FordPrfkt/NixieClock/Boards/IN14_Display/IN14_Display.png

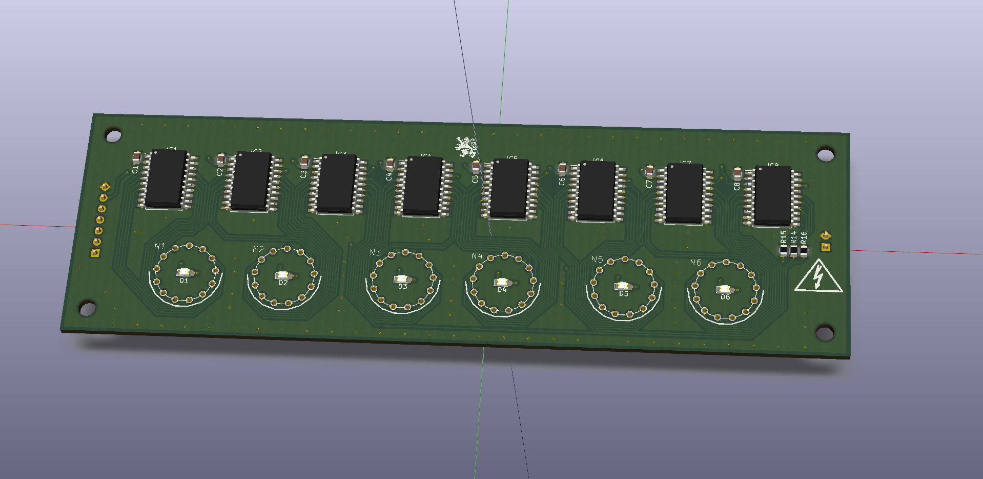
Boards/IN14_Display/IN14_Display.png
