FordPrfkt/NixieClock/Boards/Baseboard/Baseboard.png

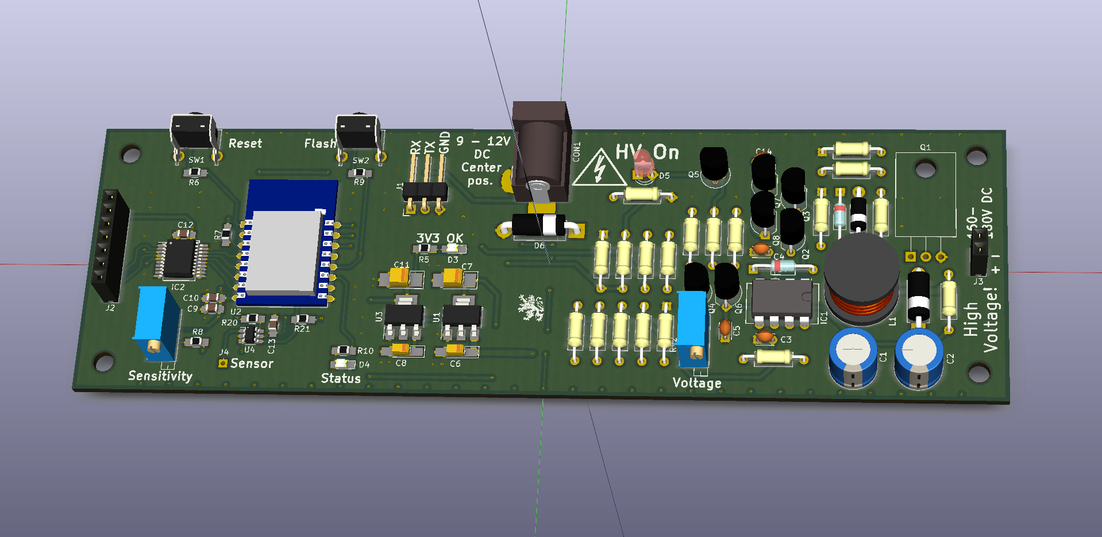
Boards/Baseboard/Baseboard.png
