FordPrfkt/NixieClock/README.md

# NixieClock
ESP12 based universal base board for nixie clocks and IN14-Tube board
