FordPrfkt/NixieClock/Boards/Baseboard/Baseboard.FCStd

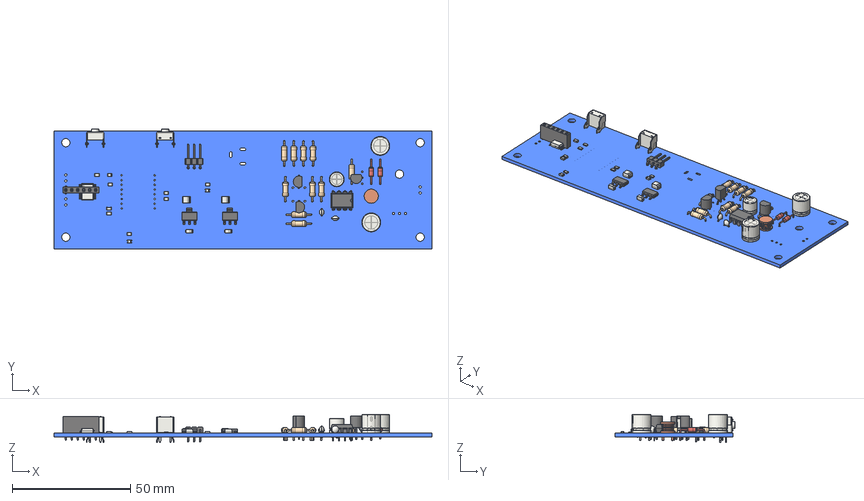
[picture p3: CAD file, 2018-03-19]
Boards/Baseboard/Baseboard.FCStd
160.0 x 50.8 x 12.0 mm
Pcb
DIP-8_W7.62mm_
TO-92_Inline_Wide_
C_0805_
C_0805_001
CP_Radial_D80mm_P350mm_
CP_Radial_D80mm_P350mm_001
C_Disc_D30mm_W20mm_P250mm_
CP_Radial_D63mm_P250mm_
C_Disc_D30mm_W20mm_P250mm_001
D_DO-35_SOD27_P10.16mm_Horizontal_
D_DO-35_SOD27_P10.16mm_Horizontal_001
D_0805_
D_0805_001
L_Radial_D6.0mm_P4.00mm_
R_Axial_DIN0207_L63mm_D25mm_P1016mm_Horizontal_
R_Axial_DIN0207_L63mm_D25mm_P1016mm_Horizontal_001
R_Axial_DIN0207_L63mm_D25mm_P1016mm_Horizontal_002
R_Axial_DIN0207_L63mm_D25mm_P1016mm_Horizontal_003
R_0805_
R_0805_001
R_0805_002
R_0805_003
R_0805_004
R_0805_005
SOT_223_
SOT_223_001
SW_Tactile_SPST_Angled_PTS645Vx39-2LFS_
SW_Tactile_SPST_Angled_PTS645Vx39-2LFS_001
CP_Tantalum_Case-A_EIA-3216-18_
CP_Tantalum_Case-B_EIA-3528-21_
CP_Tantalum_Case-A_EIA-3216-18_001
CP_Tantalum_Case-B_EIA-3528-21_001
R_Axial_DIN0207_L63mm_D25mm_P1016mm_Horizontal_004
R_Axial_DIN0207_L63mm_D25mm_P1016mm_Horizontal_005
R_Axial_DIN0207_L63mm_D25mm_P1016mm_Horizontal_006
Pin_Header_Angled_1x03_Pitch254mm_
PinSocket_1x06_P254mm_Vertical_
C_0805_002
SSOP-20_5.3x7.2mm_Pitch0.65mm_
TO-92_Inline_Wide_001
TO-92_Inline_Wide_002
R_Axial_DIN0207_L63mm_D25mm_P1016mm_Horizontal_007
R_Axial_DIN0207_L63mm_D25mm_P1016mm_Horizontal_008
R_Axial_DIN0207_L63mm_D25mm_P1016mm_Horizontal_009
