FordPrfkt/NixieClock/Boards/IN14_Display/IN14_Display.FCStd

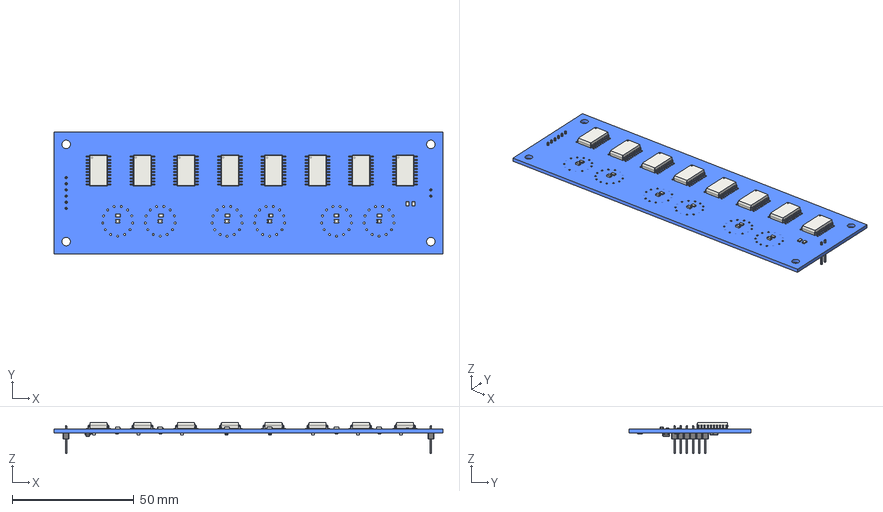
[picture p4: CAD file, 2018-03-19]
Boards/IN14_Display/IN14_Display.FCStd
160.0 x 50.0 x 12.9 mm
Pcb
C_0805_
C_0805_001
C_0805_002
C_0805_003
C_0805_004
C_0805_005
C_0805_006
D_0805_
D_0805_001
D_0805_002
D_0805_003
D_0805_004
D_0805_005
SOT_23_
SOIC-20W_7.5x12.8mm_Pitch1.27mm_
SOIC-20W_7.5x12.8mm_Pitch1.27mm_001
SOIC-20W_7.5x12.8mm_Pitch1.27mm_002
SOIC-20W_7.5x12.8mm_Pitch1.27mm_003
SOIC-20W_7.5x12.8mm_Pitch1.27mm_004
SOIC-20W_7.5x12.8mm_Pitch1.27mm_005
SOIC-20W_7.5x12.8mm_Pitch1.27mm_006
SOIC-20W_7.5x12.8mm_Pitch1.27mm_007
R_0805_
R_0805_001
R_0805_002
R_0805_003
R_0805_004
R_0805_005
R_0805_006
R_0805_007
R_0805_008
R_0805_009
R_0805_010
R_0805_011
R_0805_012
C_0805_007
Pin_Header_Straight_1x02_Pitch254mm_
Pin_Header_Straight_1x06_Pitch254mm_
R_0805_013
R_0805_014
