FordPrfkt/NixieClock/Boards/Baseboard/Baseboard.pdf

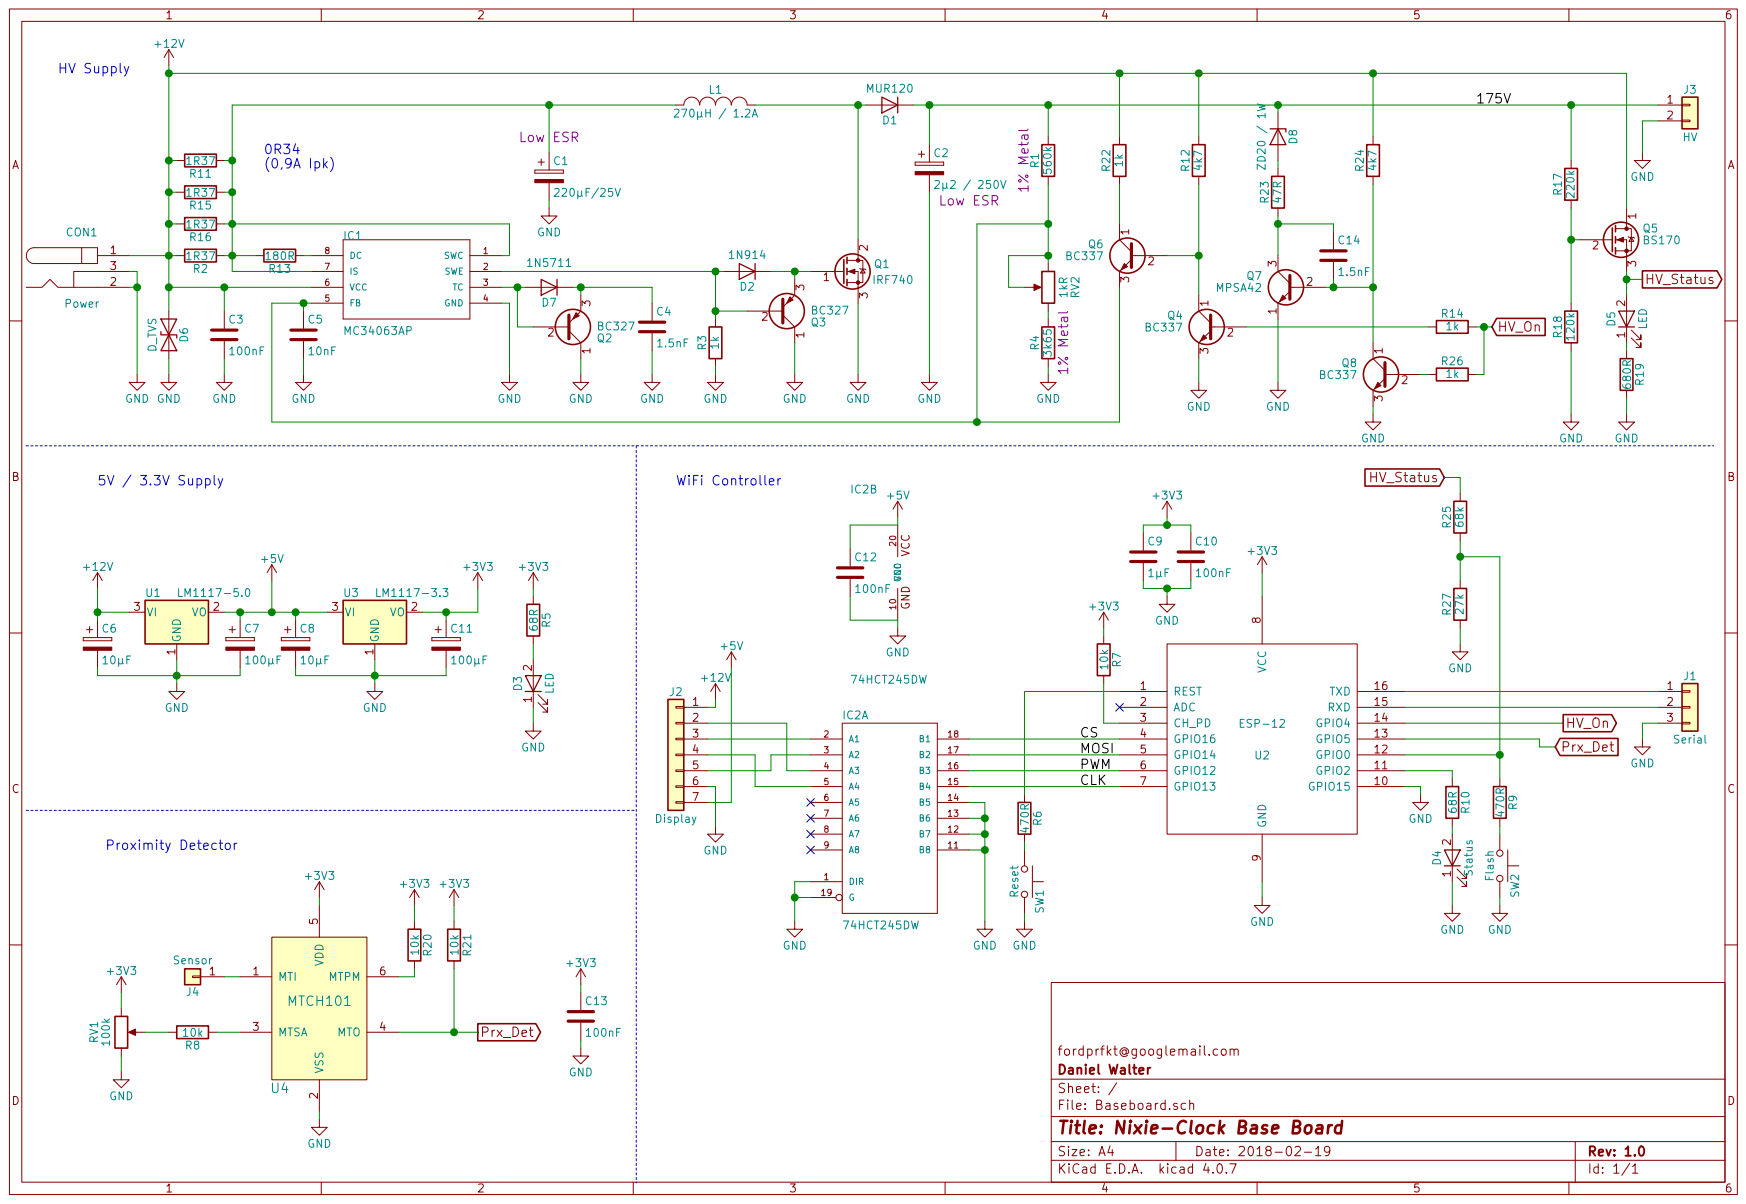
[picture p5: page 1]
