FordPrfkt/NixieClock/Boards/IN14_Display/IN14_Display.pdf

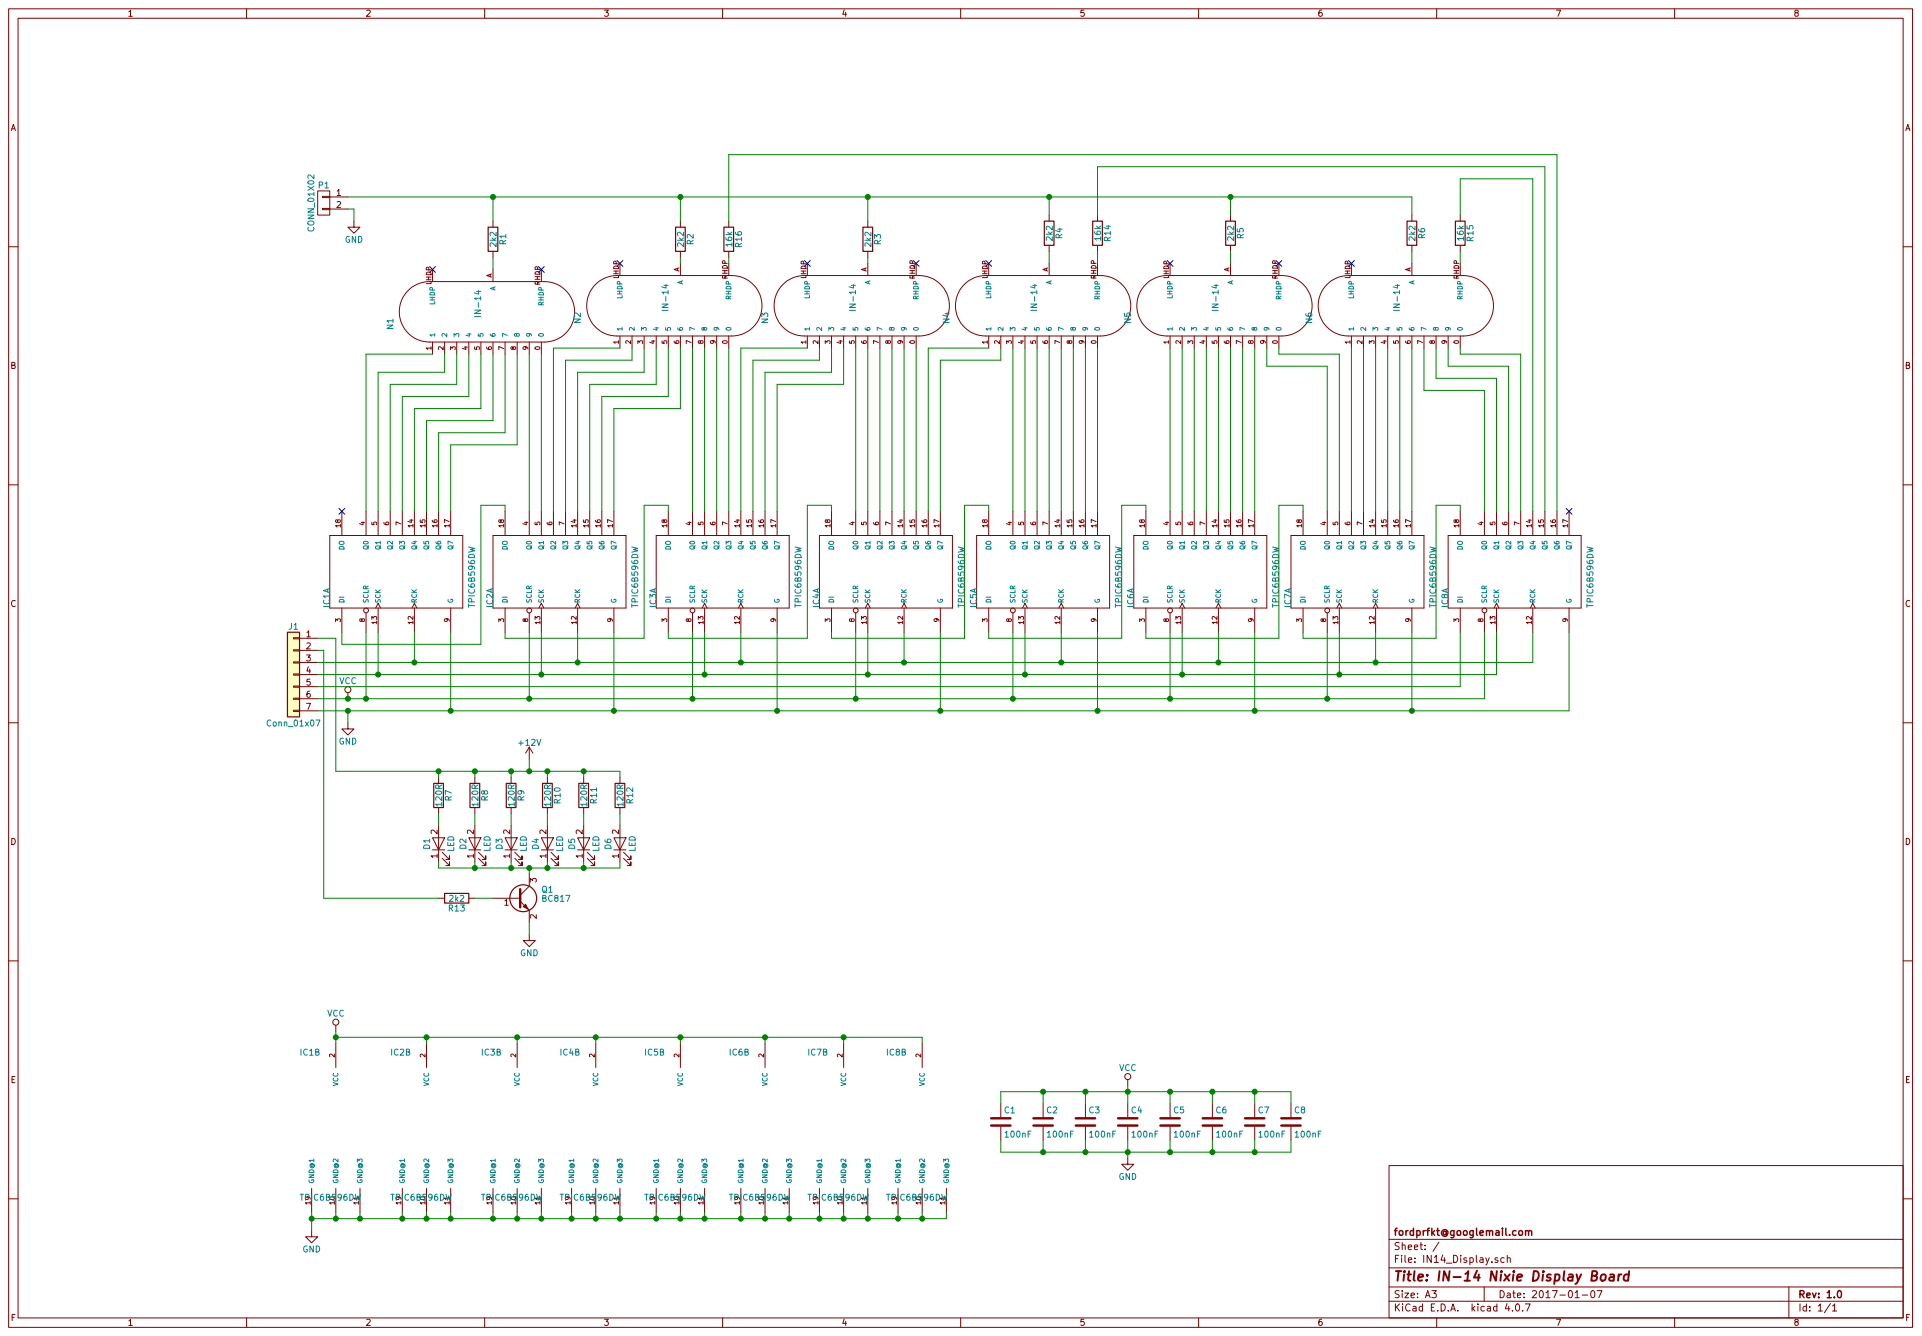
[picture p6: page 1]
