FordPrfkt/NixieClock/(list of files, drawings)

Other design files:
Boards/IN14_Display/IN14_Display.dsn
