FordPrfkt/NixieClock/Boards/Baseboard/Baseboard.kicad_pcb

## KiCad design Boards/Baseboard/Baseboard.kicad_pcb (2018-12-07)

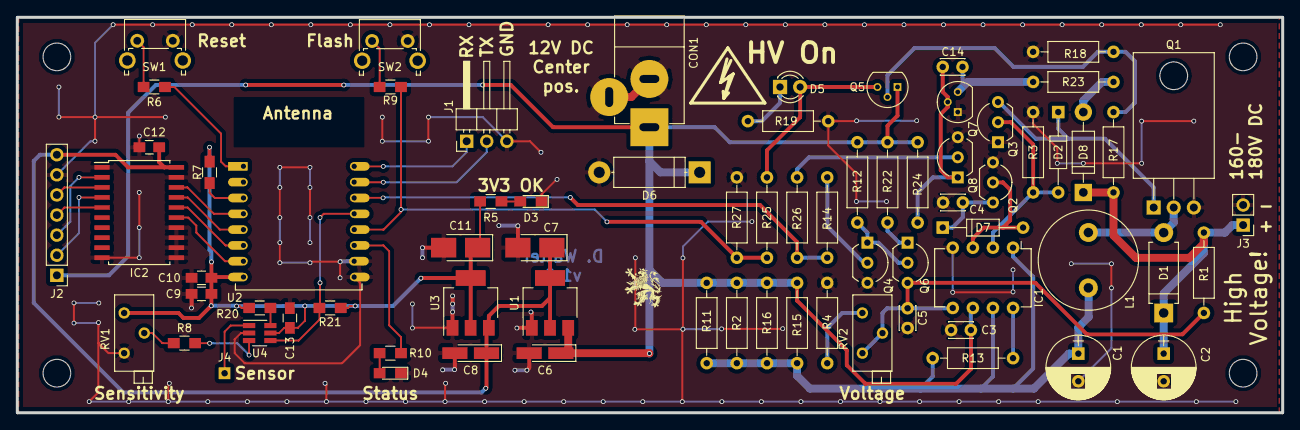
[picture p7: board Baseboard.kicad_pcb from above]

Board: 2 copper layers, 160.0 x 50.0 mm, 73 parts (0 on the bottom side), 48 nets.

Parts:
C1: 220µF/25V; CP_Radial_D8.0mm_P3.50mm
C2: 2µ2 / 250V; CP_Radial_D8.0mm_P3.50mm
C3: 100nF; C_Disc_D3.0mm_W2.0mm_P2.50mm
C4, C14: 1.5nF; C_Disc_D3.0mm_W2.0mm_P2.50mm
C5: 10nF; C_Disc_D3.0mm_W2.0mm_P2.50mm
C6, C8: 10µF; CP_Tantalum_Case-A_EIA-3216-18_Hand
C7, C11: 100µF; CP_Tantalum_Case-B_EIA-3528-21_Hand
C9: 1µF; C_0805_HandSoldering
C10, C12, C13: 100nF; C_0805_HandSoldering
CON1: Power; JACK_ALIM
D1: MUR120; D_DO-15_P10.16mm_Horizontal
D2: 1N914; D_DO-35_SOD27_P10.16mm_Horizontal
D3: LED; LED_0805_HandSoldering
D4: Status; LED_0805_HandSoldering
D5: LED; LED_D3.0mm
D6: D_TVS; D_5W_P12.70mm_Horizontal
D7: 1N5711; D_DO-35_SOD27_P10.16mm_Horizontal
D8: ZD20 / 1W; D_DO-41_SOD81_P10.16mm_Horizontal
IC1: MC34063AP; DIP-8_W7.62mm
IC2: 74HCT245DW; SOIC-20W_7.5x12.8mm_Pitch1.27mm
J1: Serial; Pin_Header_Angled_1x03_Pitch2.54mm
J2: Display; Socket_Strip_Straight_1x07_Pitch2.54mm
J3: HV; Socket_Strip_Straight_1x02_Pitch2.54mm
J4: Sensor; Measurement_Point_Square-TH_Small
L1: 270µH / 1.2A; L_Radial_D12.5mm_P7.00mm_Fastron_09HCP
Q1: IRF740; TO-220-3_Horizontal
Q2, Q3: BC327; TO-92_Inline_Wide
Q4, Q6, Q8: BC337; TO-92_Inline_Wide
Q5: BS170; TO-92_Molded_Narrow
Q7: MPSA42; TO-92_Molded_Narrow
R1: 560k; R_Axial_DIN0207_L6.3mm_D2.5mm_P10.16mm_Horizontal
R2, R11, R15, R16: 1R37; R_Axial_DIN0207_L6.3mm_D2.5mm_P10.16mm_Horizontal
R3, R14, R22, R26: 1k; R_Axial_DIN0207_L6.3mm_D2.5mm_P10.16mm_Horizontal
R4: 3k65; R_Axial_DIN0207_L6.3mm_D2.5mm_P10.16mm_Horizontal
R5, R10: 68R; R_0805_HandSoldering
R6, R9: 470R; R_0805_HandSoldering
R7, R8, R20, R21: 10k; R_0805_HandSoldering
R12, R24: 4k7; R_Axial_DIN0207_L6.3mm_D2.5mm_P10.16mm_Horizontal
R13: 180R; R_Axial_DIN0207_L6.3mm_D2.5mm_P10.16mm_Horizontal
R17: 220k; R_Axial_DIN0207_L6.3mm_D2.5mm_P10.16mm_Horizontal
R18: 120k; R_Axial_DIN0207_L6.3mm_D2.5mm_P10.16mm_Horizontal
R19: 680R; R_Axial_DIN0207_L6.3mm_D2.5mm_P10.16mm_Horizontal
R23: 47R; R_Axial_DIN0207_L6.3mm_D2.5mm_P10.16mm_Horizontal
R25: 68k; R_Axial_DIN0207_L6.3mm_D2.5mm_P10.16mm_Horizontal
R27: 27k; R_Axial_DIN0207_L6.3mm_D2.5mm_P10.16mm_Horizontal
RV1: 100k; Potentiometer_Trimmer_Bourns_3296Z
RV2: 1kR; Potentiometer_Trimmer_Bourns_3296Z
SW1: Reset; SW_Tactile_SPST_Angled_PTS645Vx39-2LFS
SW2: Flash; SW_Tactile_SPST_Angled_PTS645Vx39-2LFS
U1: LM1117-5.0; SOT-223-3_TabPin2
U2: ESP-12
U3: LM1117-3.3; SOT-223-3_TabPin2
U4: MTCH101; SOT-23-6_Handsoldering

Connections:
+3V3: C9.1, C10.1, C11.1, C13.1, R5.1, R7.1, R20.1, R21.1, RV1.1, U2.8, U3.2, U4.5
+5V: C7.1, C8.1, C12.1, IC2.20, J2.7, U1.2, U3.3
+12V: C3.1, C6.1, CON1.1, D6.1, IC1.6, J2.1, Q5.1, R2.2, R11.2, R12.2, R15.2, R16.2, R22.2, R24.2, U1.3
/175V: C2.1, D1.1, D8.1, J3.1, R1.2, R17.2
/CLK: IC2.15, U2.7
/CS: IC2.18, U2.4
/MOSI: IC2.17, U2.5
/PWM: IC2.16, U2.6
GND: C1.2, C2.2, C3.2, C4.2, C5.2, C6.2, C7.2, C8.2, C9.2, C10.2, C11.2, C12.2, C13.2, CON1.2, CON1.3, D3.1, D4.1, D6.2, IC1.4, IC2.1, IC2.10, IC2.11, IC2.12, IC2.13, IC2.14, IC2.19, J1.3, J2.6, J3.2, Q1.3, Q2.1, Q3.1, Q4.3, Q7.1, Q8.3, R3.1, R4.1, R18.1, R19.2, R27.1, RV1.3, SW1.2, SW2.2, U1.1, U2.9, U2.10, U3.1, U4.2
HV_On: R14.2, R26.2, U2.14
HV_Status: D5.2, Q5.3, R25.2
unnamed: C1.1, IC1.1, IC1.7, L1.1, R2.1, R11.1, R13.2, R15.1, R16.1
unnamed: C4.1, D7.1, Q2.3
unnamed: C5.1, IC1.5, Q6.3, R1.1, RV2.2, RV2.3
unnamed: C14.1, Q7.3, R23.1
unnamed: C14.2, Q7.2, Q8.1, R24.1
unnamed: D1.2, L1.2, Q1.2
unnamed: D2.1, Q1.1, Q3.3
unnamed: D2.2, IC1.2, Q3.2, R3.2
unnamed: D3.2, R5.2
unnamed: D4.2, R10.2
unnamed: D5.1, R19.1
unnamed: D7.2, IC1.3, Q2.2
unnamed: D8.2, R23.2
unnamed: IC1.8, R13.1
unnamed: IC2.2, J2.3
unnamed: IC2.3, J2.5
unnamed: IC2.4, J2.2
unnamed: IC2.5, J2.4
unnamed: J1.1, U2.16
unnamed: J1.2, U2.15
unnamed: J4.1, U4.1
unnamed: Q4.1, Q6.2, R12.1
unnamed: Q4.2, R14.1
unnamed: Q5.2, R17.1, R18.2
unnamed: Q6.1, R22.1
unnamed: Q8.2, R26.1
unnamed: R4.2, RV2.1
unnamed: R6.1, U2.1
unnamed: R6.2, SW1.1
unnamed: R7.2, U2.3
unnamed: R8.1, U4.3
unnamed: R8.2, RV1.2
unnamed: R9.2, SW2.1
unnamed: R10.1, U2.11
unnamed: R20.2, U4.6
unnamed: R9.1, R25.1, R27.2, U2.12
Prx_Det: R21.2, U2.13, U4.4
