FordPrfkt/NixieClock/Boards/IN14_Display/IN14_Display.kicad_pcb

## KiCad design Boards/IN14_Display/IN14_Display.kicad_pcb (2018-12-07)

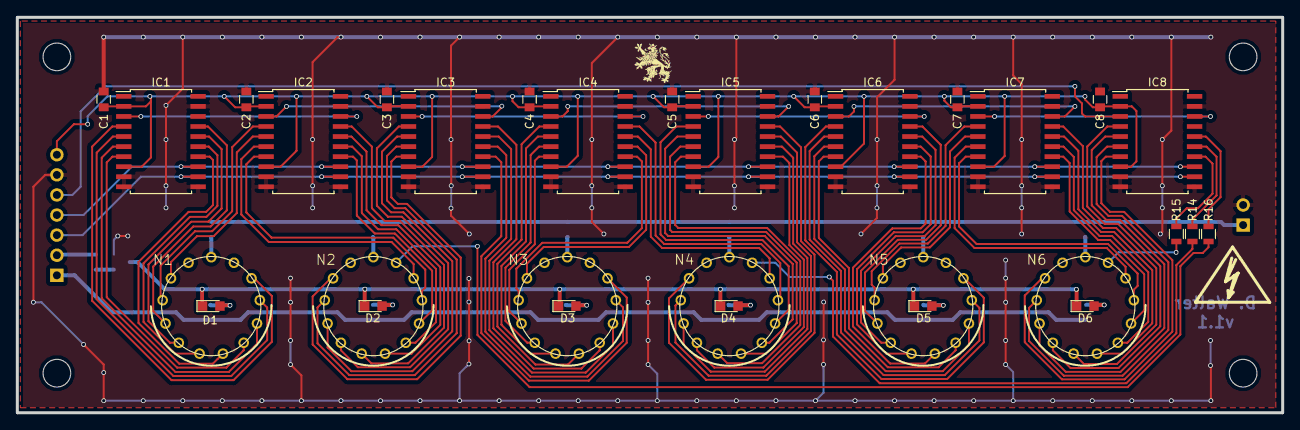
[picture p8: board IN14_Display.kicad_pcb from above]

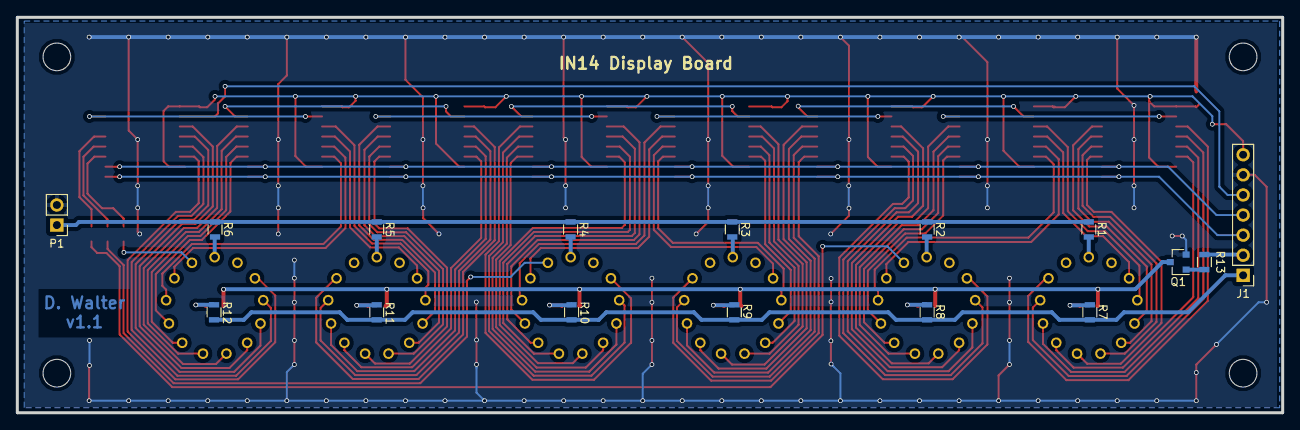
[picture p9: board IN14_Display.kicad_pcb from below]

Board: 2 copper layers, 160.0 x 50.0 mm, 47 parts (16 on the bottom side), 95 nets.

Parts:
C1, C2, C3, C4, C5, C6, C7, C8: 100nF; C_0805
D1, D2, D3, D4, D5, D6: LED; LED_0805
IC1, IC2, IC3, IC4, IC5, IC6, IC7, IC8: TPIC6B596DW; SOIC-20W_7.5x12.8mm_Pitch1.27mm
J1: Conn_01x07; Pin_Header_Straight_1x07_Pitch2.54mm
N1, N2, N3, N4, N5, N6: IN-14; russian-nixies-IN-14
P1: CONN_01X02; Pin_Header_Straight_1x02_Pitch2.54mm
Q1: BC817; SOT-23
R1, R2, R3, R4, R5, R6, R13: 2k2; R_0805
R7, R8, R9, R10, R11, R12: 120R; R_0805
R14, R15, R16: 16k; R_0805

Connections:
+12V: J1.1, R7.1, R8.1, R9.1, R10.1, R11.1, R12.1
GND: C1.2, C2.2, C3.2, C4.2, C5.2, C6.2, C7.2, C8.2, IC1.9, IC1.10, IC1.11, IC1.19, IC2.9, IC2.10, IC2.11, IC2.19, IC3.9, IC3.10, IC3.11, IC3.19, IC4.9, IC4.10, IC4.11, IC4.19, IC5.9, IC5.10, IC5.11, IC5.19, IC6.9, IC6.10, IC6.11, IC6.19, IC7.9, IC7.10, IC7.11, IC7.19, IC8.9, IC8.10, IC8.11, IC8.19, J1.6, P1.2, Q1.2
unnamed: D1.1, D2.1, D3.1, D4.1, D5.1, D6.1, Q1.3
unnamed: D1.2, R7.2
unnamed: D2.2, R8.2
unnamed: D3.2, R9.2
unnamed: D4.2, R10.2
unnamed: D5.2, R11.2
unnamed: D6.2, R12.2
unnamed: IC1.3, IC2.18
unnamed: IC1.4, N1.1
unnamed: IC1.5, N1.2
unnamed: IC1.6, N1.3
unnamed: IC1.7, N1.4
unnamed: IC1.12, IC2.12, IC3.12, IC4.12, IC5.12, IC6.12, IC7.12, IC8.12, J1.3
unnamed: IC1.13, IC2.13, IC3.13, IC4.13, IC5.13, IC6.13, IC7.13, IC8.13, J1.4
unnamed: IC1.14, N1.5
unnamed: IC1.15, N1.6
unnamed: IC1.16, N1.7
unnamed: IC1.17, N1.8
unnamed: IC2.3, IC3.18
unnamed: IC2.4, N1.9
unnamed: IC2.5, N1.0
unnamed: IC2.6, N2.1
unnamed: IC2.7, N2.2
unnamed: IC2.14, N2.3
unnamed: IC2.15, N2.4
unnamed: IC2.16, N2.5
unnamed: IC2.17, N2.6
unnamed: IC3.3, IC4.18
unnamed: IC3.4, N2.7
unnamed: IC3.5, N2.8
unnamed: IC3.6, N2.9
unnamed: IC3.7, N2.0
unnamed: IC3.14, N3.1
unnamed: IC3.15, N3.2
unnamed: IC3.16, N3.3
unnamed: IC3.17, N3.4
unnamed: IC4.3, IC5.18
unnamed: IC4.4, N3.5
unnamed: IC4.5, N3.6
unnamed: IC4.6, N3.7
unnamed: IC4.7, N3.8
unnamed: IC4.14, N3.9
unnamed: IC4.15, N3.0
unnamed: IC4.16, N4.1
unnamed: IC4.17, N4.2
unnamed: IC5.3, IC6.18
unnamed: IC5.4, N4.3
unnamed: IC5.5, N4.4
unnamed: IC5.6, N4.5
unnamed: IC5.7, N4.6
unnamed: IC5.14, N4.7
unnamed: IC5.15, N4.8
unnamed: IC5.16, N4.9
unnamed: IC5.17, N4.0
unnamed: IC6.3, IC7.18
unnamed: IC6.4, N5.1
unnamed: IC6.5, N5.2
unnamed: IC6.6, N5.3
unnamed: IC6.7, N5.4
unnamed: IC6.14, N5.5
unnamed: IC6.15, N5.6
unnamed: IC6.16, N5.7
unnamed: IC6.17, N5.8
unnamed: IC7.3, IC8.18
unnamed: IC7.4, N5.9
unnamed: IC7.5, N5.0
unnamed: IC7.6, N6.1
unnamed: IC7.7, N6.2
unnamed: IC7.14, N6.3
unnamed: IC7.15, N6.4
unnamed: IC7.16, N6.5
unnamed: IC7.17, N6.6
unnamed: IC8.3, J1.5
unnamed: IC8.4, N6.7
unnamed: IC8.5, N6.8
unnamed: IC8.6, N6.9
unnamed: IC8.7, N6.0
unnamed: IC8.14, R15.1
unnamed: IC8.15, R14.1
unnamed: IC8.16, R16.1
unnamed: J1.2, R13.2
unnamed: N1.A, R1.2
unnamed: N2.A, R2.2
unnamed: N2.RHDP, R16.2
unnamed: N3.A, R3.2
unnamed: N4.A, R4.2
unnamed: N4.RHDP, R14.2
unnamed: N5.A, R5.2
unnamed: N6.A, R6.2
unnamed: N6.RHDP, R15.2
unnamed: P1.1, R1.1, R2.1, R3.1, R4.1, R5.1, R6.1
unnamed: Q1.1, R13.1
VCC: C1.1, C2.1, C3.1, C4.1, C5.1, C6.1, C7.1, C8.1, IC1.2, IC1.8, IC2.2, IC2.8, IC3.2, IC3.8, IC4.2, IC4.8, IC5.2, IC5.8, IC6.2, IC6.8, IC7.2, IC7.8, IC8.2, IC8.8, J1.7
