FordPrfkt/NixieClock/(commit log)

2018-02-18 Initial Commiz
    [Baseboard.kicad_pcb, Baseboard.sch, Controller.sch, HVSupply.sch, IN14_Display.dsn, IN14_Display.kicad_pcb, IN14_Display.sch, LogicSupply.sch]
2018-02-18 Removed old schematics
    [Controller.sch, HVSupply.sch, LogicSupply.sch]
2018-02-19 Layout chnages
    [Baseboard.kicad_pcb, Baseboard.sch, IN14_Display.kicad_pcb, IN14_Display.sch]
2018-03-19 Board layout done
    [Baseboard.kicad_pcb, Baseboard.sch, IN14_Display.kicad_pcb, IN14_Display.sch]
2018-06-23 Layout done, before PCB order
    [Baseboard-B.Cu.gbl, Baseboard-B.Mask.gbs, Baseboard-B.SilkS.gbo, Baseboard-Edge.Cuts.gm1, Baseboard-F.Cu.gtl, Baseboard-F.Mask.gts, Baseboard-F.SilkS.gto, Baseboard.drl]
2018-12-07 Production Version, Firmware Work in Progress
    [Baseboard-B.Cu.gbl, Baseboard-B.Mask.gbs, Baseboard-B.SilkS.gbo, Baseboard-Edge.Cuts.gm1, Baseboard-F.Cu.gtl, Baseboard-F.Mask.gts, Baseboard-F.SilkS.gto, Baseboard-NPTH.drl]
